jdavidguerrero/groovepush/hardware/boards/fab/pcb-a/pcb-a-bom.csv

Comment | Designator | Footprint | LCSC Part #
100nF | C1 | C_0603_1608Metric | C14663
10uF | C2 | C_0805_2012Metric | C15850
10nF | C10,C11,C12,C13,C14,C15,C16,C17,C18,C19,C20,C21,C22,C23,C24,C25 | C_0603_1608Metric | C57112
SM04B-SRSS-TB | J2 | JST_SH_SM04B-SRSS-TB_1x04-1MP_P1.00mm_Horizontal | C160404
SM06B-SRSS-TB | J3 | JST_SH_SM06B-SRSS-TB_1x06-1MP_P1.00mm_Horizontal | C160405
SM10B-SRSS-TB | J4 | JST_SH_SM10B-SRSS-TB_1x10-1MP_P1.00mm_Horizontal | C160409
4.7k | R1,R2 | R_0603_1608Metric | C23162
MCP23017T-E/SS | U1 | SSOP-28_5.3x10.2mm_P0.65mm | C558584
