jdavidguerrero/groovepush/hardware/boards/pcb-k2/pcb-k2.kicad_pcb

## KiCad design hardware/boards/pcb-k2/pcb-k2.kicad_pcb (2026-10-22)

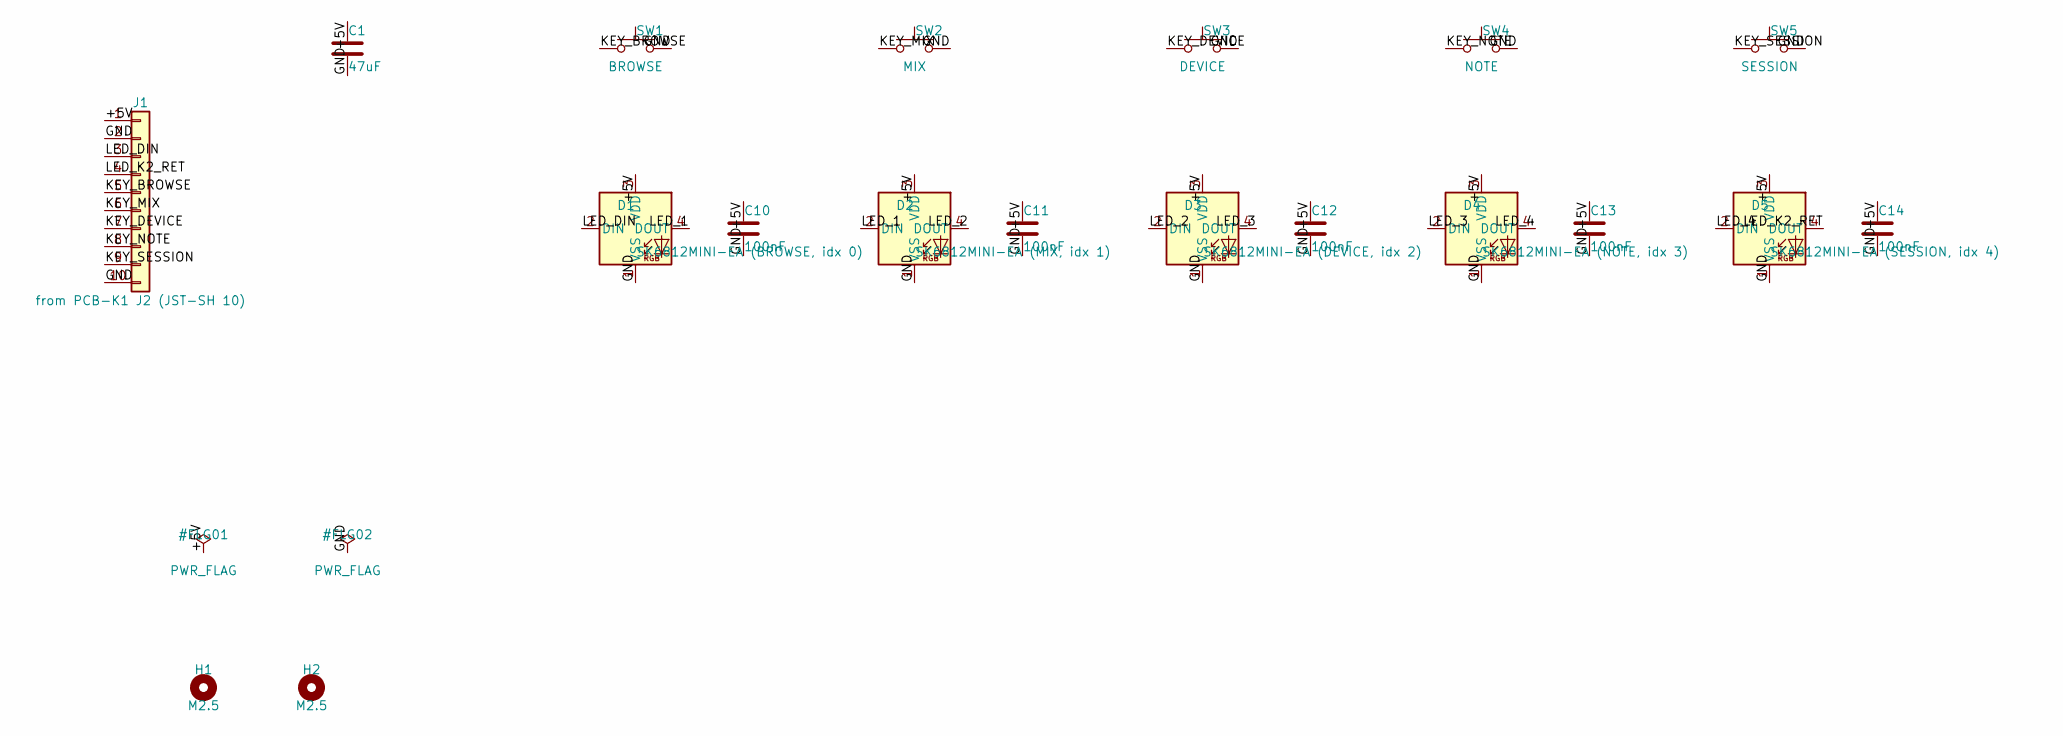
[picture p1: schematic pcb-k2.kicad_sch]

Parts:
C1: 47uF; C_1206_3216Metric
C10, C11, C12, C13, C14: 100nF; C_0603_1608Metric
D1: SK6812MINI-EA (BROWSE, idx 0); LED_SK6812MINI-E_3.2x2.8mm_P1.5mm_ReverseMount
D2: SK6812MINI-EA (MIX, idx 1); LED_SK6812MINI-E_3.2x2.8mm_P1.5mm_ReverseMount
D3: SK6812MINI-EA (DEVICE, idx 2); LED_SK6812MINI-E_3.2x2.8mm_P1.5mm_ReverseMount
D4: SK6812MINI-EA (NOTE, idx 3); LED_SK6812MINI-E_3.2x2.8mm_P1.5mm_ReverseMount
D5: SK6812MINI-EA (SESSION, idx 4); LED_SK6812MINI-E_3.2x2.8mm_P1.5mm_ReverseMount
H1, H2: M2.5; MountingHole_2.7mm_M2.5
J1: from PCB-K1 J2 (JST-SH 10); JST_SH_SM10B-SRSS-TB_1x10-1MP_P1.00mm_Horizontal
SW1: BROWSE; SW_Kailh_Choc_V2_1u
SW2: MIX; SW_Kailh_Choc_V2_1u
SW3: DEVICE; SW_Kailh_Choc_V2_1u
SW4: NOTE; SW_Kailh_Choc_V2_1u
SW5: SESSION; SW_Kailh_Choc_V2_1u

Connections:
/+5V: C1.1, C10.1, C11.1, C12.1, C13.1, C14.1, D1.3 (VDD), D2.3 (VDD), D3.3 (VDD), D4.3 (VDD), D5.3 (VDD), J1.1
/GND: C1.2, C10.2, C11.2, C12.2, C13.2, C14.2, D1.1 (VSS), D2.1 (VSS), D3.1 (VSS), D4.1 (VSS), D5.1 (VSS), J1.2, J1.10, SW1.2, SW2.2, SW3.2, SW4.2, SW5.2
/KEY_BROWSE: J1.5, SW1.1
/KEY_DEVICE: J1.7, SW3.1
/KEY_MIX: J1.6, SW2.1
/KEY_NOTE: J1.8, SW4.1
/KEY_SESSION: J1.9, SW5.1
/LED_1: D1.4 (DOUT), D2.2 (DIN)
/LED_2: D2.4 (DOUT), D3.2 (DIN)
/LED_3: D3.4 (DOUT), D4.2 (DIN)
/LED_4: D4.4 (DOUT), D5.2 (DIN)
/LED_DIN: D1.2 (DIN), J1.3
/LED_K2_RET: D5.4 (DOUT), J1.4

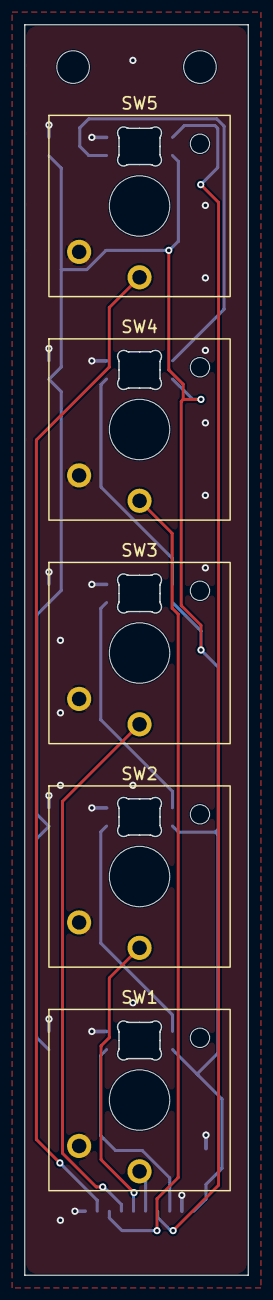
[picture p2: board pcb-k2.kicad_pcb from above]

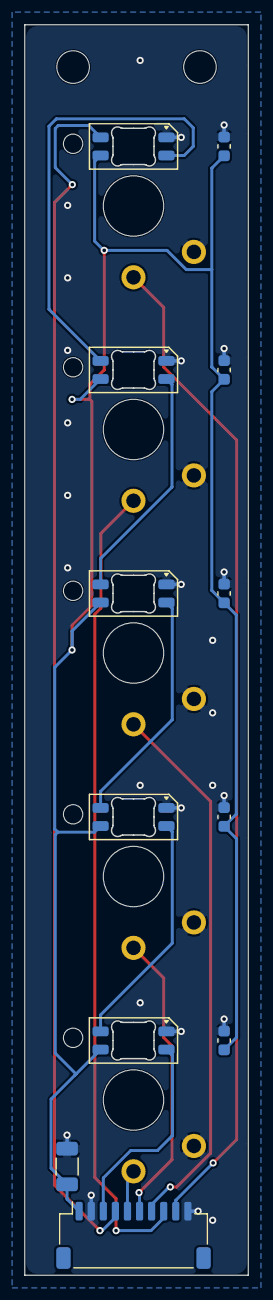
[picture p3: board pcb-k2.kicad_pcb from below]

Board: 2 copper layers, 18.5 x 103.5 mm, 19 parts (12 on the bottom side), 13 nets.
