jdavidguerrero/groovepush/hardware/boards/pcb-a/pcb-a.kicad_pcb

## KiCad design hardware/boards/pcb-a/pcb-a.kicad_pcb (2026-10-22)

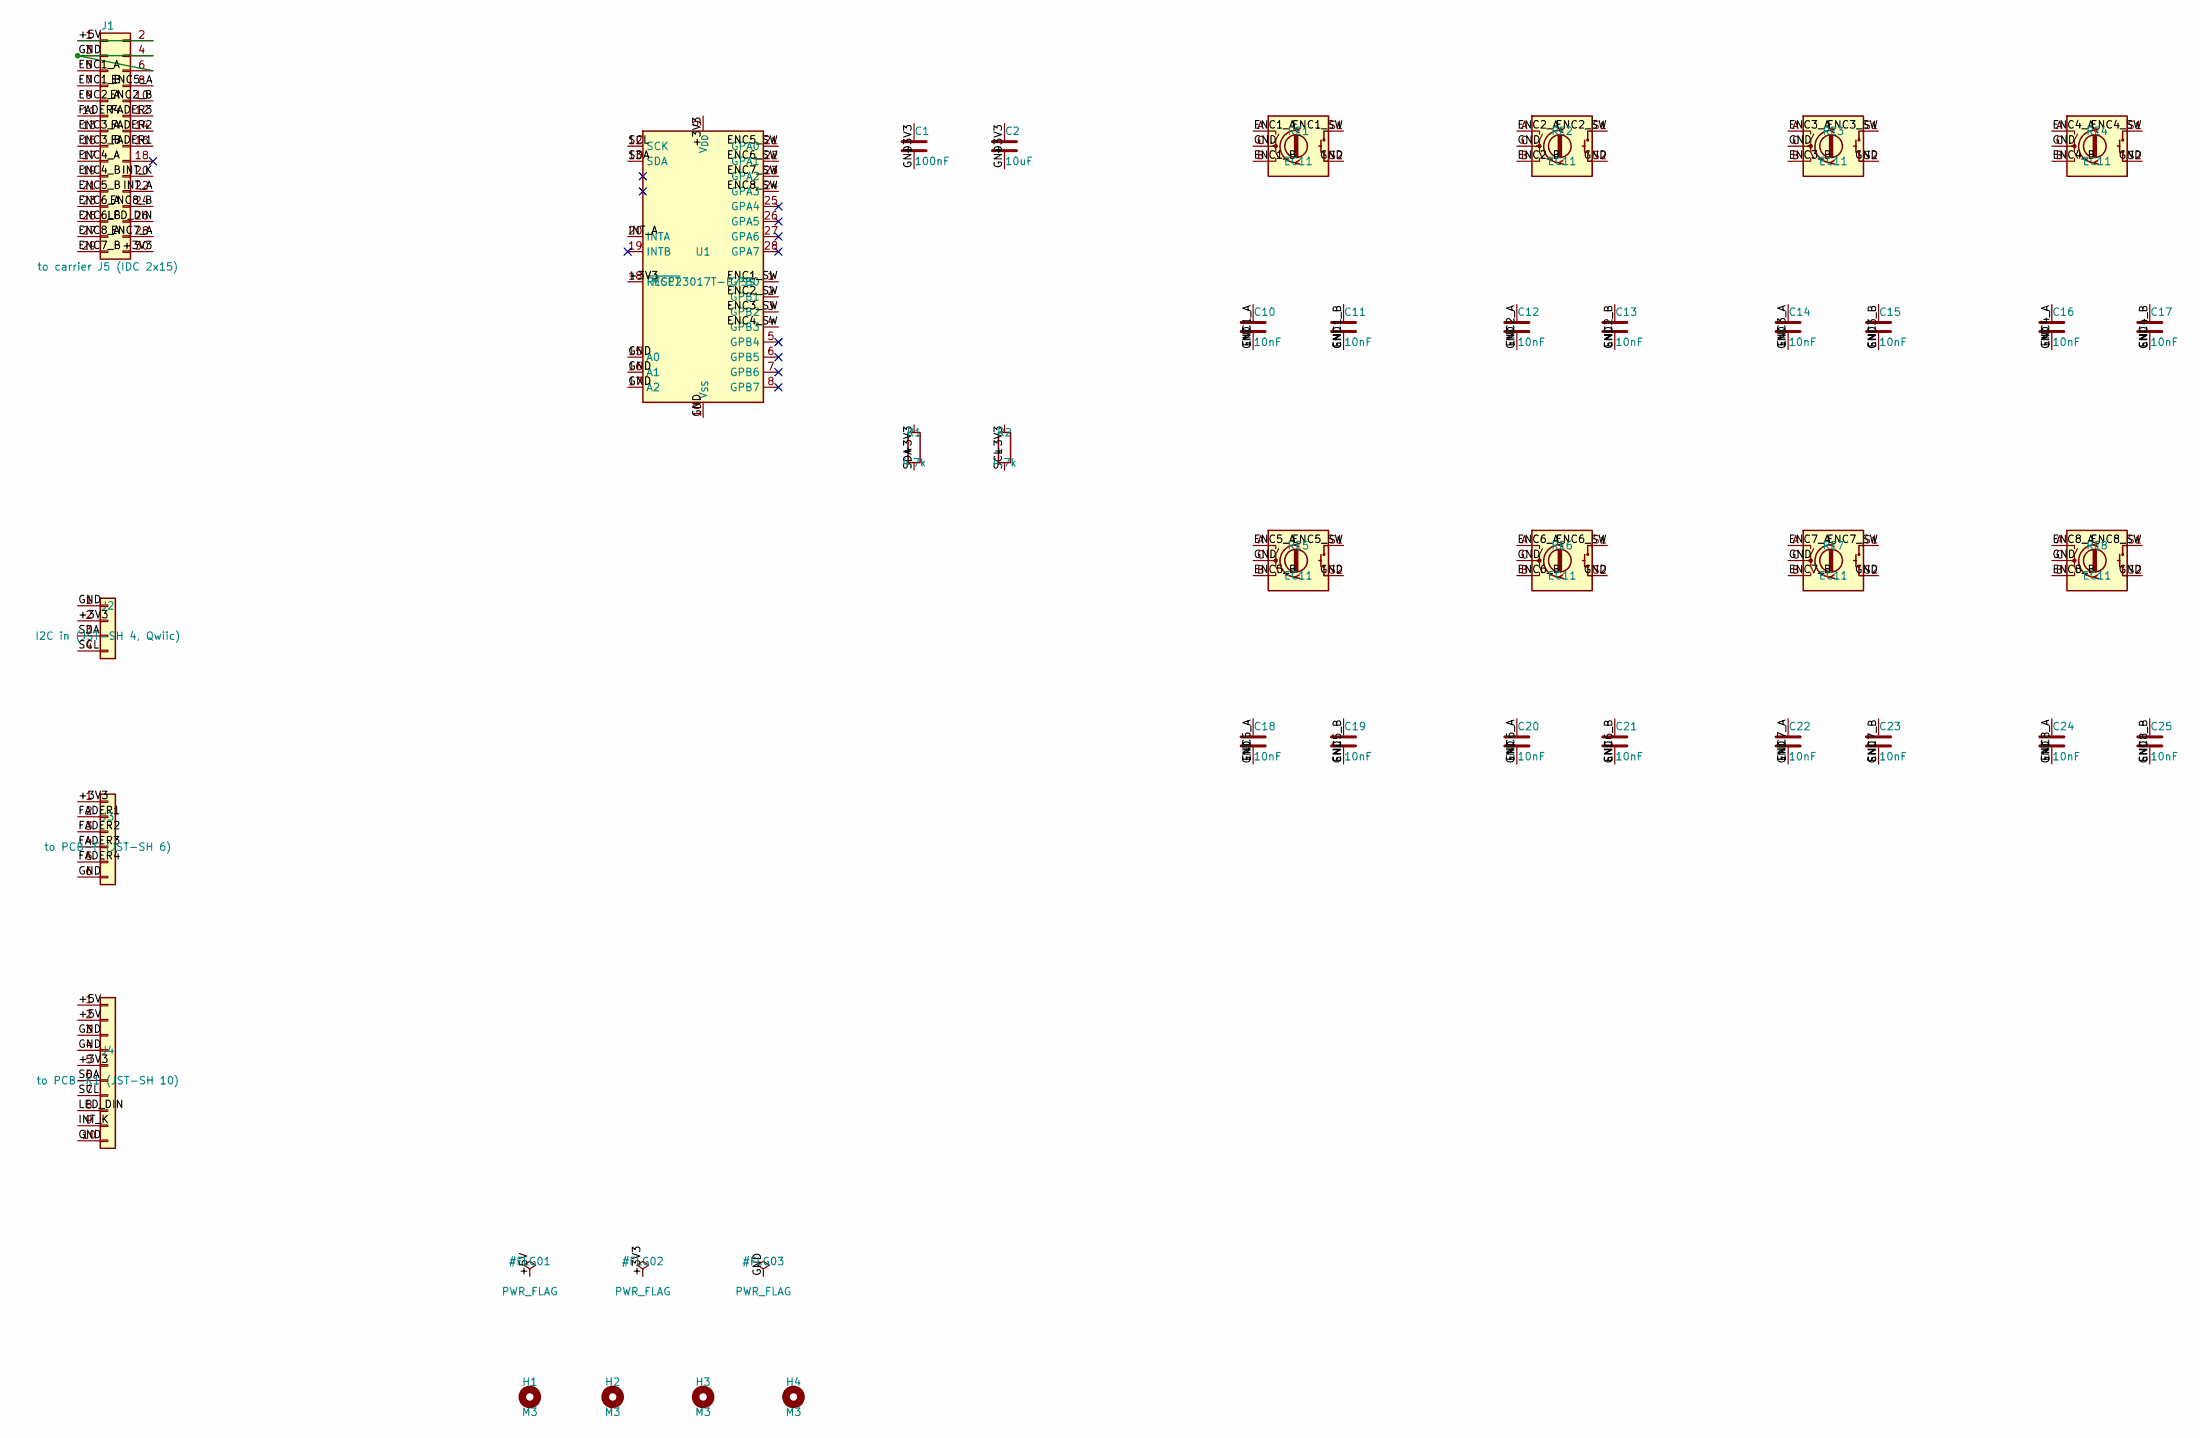
[picture p4: schematic pcb-a.kicad_sch]

Parts:
C1: 100nF; C_0603_1608Metric; LCSC C14663
C2: 10uF; C_0805_2012Metric; LCSC C15850
C10, C11, C12, C13, C14, C15, C16, C17, C18, C19, C20, C21, C22, C23, C24, C25: 10nF; C_0603_1608Metric; LCSC C57112
H1, H2, H3, H4: M3; MountingHole_3.2mm_M3
J1: to carrier J5 (IDC 2x15); IDC-Header_2x15_P2.54mm_Vertical
J2: I2C in (JST-SH 4, Qwiic); JST_SH_SM04B-SRSS-TB_1x04-1MP_P1.00mm_Horizontal; LCSC C160404
J3: to PCB-F (JST-SH 6); JST_SH_SM06B-SRSS-TB_1x06-1MP_P1.00mm_Horizontal; LCSC C160405
J4: to PCB-K1 (JST-SH 10); JST_SH_SM10B-SRSS-TB_1x10-1MP_P1.00mm_Horizontal; LCSC C160409
R1, R2: 4.7k; R_0603_1608Metric; LCSC C23162
RE1, RE2, RE3, RE4, RE5, RE6, RE7, RE8: EC11; RotaryEncoder_Alps_EC11E-Switch_Vertical_H20mm
U1: MCP23017T-E/SS; SSOP-28_5.3x10.2mm_P0.65mm; LCSC C558584

Connections:
/+3V3: C1.1, C2.1, J1.30, J2.2, J3.1, J4.5, R1.1, R2.1, U1.9 (V_{DD}), U1.18 (~RESET)
/+5V: J1.1, J1.2, J4.1, J4.2
/ENC1_A: C10.1, J1.5, RE1.A
/ENC1_B: C11.1, J1.7, RE1.B
/ENC1_SW: RE1.S1, U1.1 (GPB0)
/ENC2_A: C12.1, J1.9, RE2.A
/ENC2_B: C13.1, J1.10, RE2.B
/ENC2_SW: RE2.S1, U1.2 (GPB1)
/ENC3_A: C14.1, J1.13, RE3.A
/ENC3_B: C15.1, J1.15, RE3.B
/ENC3_SW: RE3.S1, U1.3 (GPB2)
/ENC4_A: C16.1, J1.17, RE4.A
/ENC4_B: C17.1, J1.19, RE4.B
/ENC4_SW: RE4.S1, U1.4 (GPB3)
/ENC5_A: C18.1, J1.8, RE5.A
/ENC5_B: C19.1, J1.21, RE5.B
/ENC5_SW: RE5.S1, U1.21 (GPA0)
/ENC6_A: C20.1, J1.23, RE6.A
/ENC6_B: C21.1, J1.25, RE6.B
/ENC6_SW: RE6.S1, U1.22 (GPA1)
/ENC7_A: C22.1, J1.28, RE7.A
/ENC7_B: C23.1, J1.29, RE7.B
/ENC7_SW: RE7.S1, U1.23 (GPA2)
/ENC8_A: C24.1, J1.27, RE8.A
/ENC8_B: C25.1, J1.24, RE8.B
/ENC8_SW: RE8.S1, U1.24 (GPA3)
/FADER1: J1.16, J3.2
/FADER2: J1.14, J3.3
/FADER3: J1.12, J3.4
/FADER4: J1.11, J3.5
/GND: C1.2, C2.2, C10.2, C11.2, C12.2, C13.2, C14.2, C15.2, C16.2, C17.2, C18.2, C19.2, C20.2, C21.2, C22.2, C23.2, C24.2, C25.2, J1.3, J1.4, J1.6, J2.1, J3.6, J4.3, J4.4, J4.10, RE1.C, RE1.S2, RE2.C, RE2.S2, RE3.C, RE3.S2, RE4.C, RE4.S2, RE5.C, RE5.S2, RE6.C, RE6.S2, RE7.C, RE7.S2, RE8.C, RE8.S2, U1.10 (V_{SS}), U1.15 (A0), U1.16 (A1), U1.17 (A2)
/INT_A: J1.22, U1.20 (INTA)
/INT_K: J1.20, J4.9
/LED_DIN: J1.26, J4.8
/SCL: J2.4, J4.7, R2.2, U1.12 (SCK)
/SDA: J2.3, J4.6, R1.2, U1.13 (SDA)

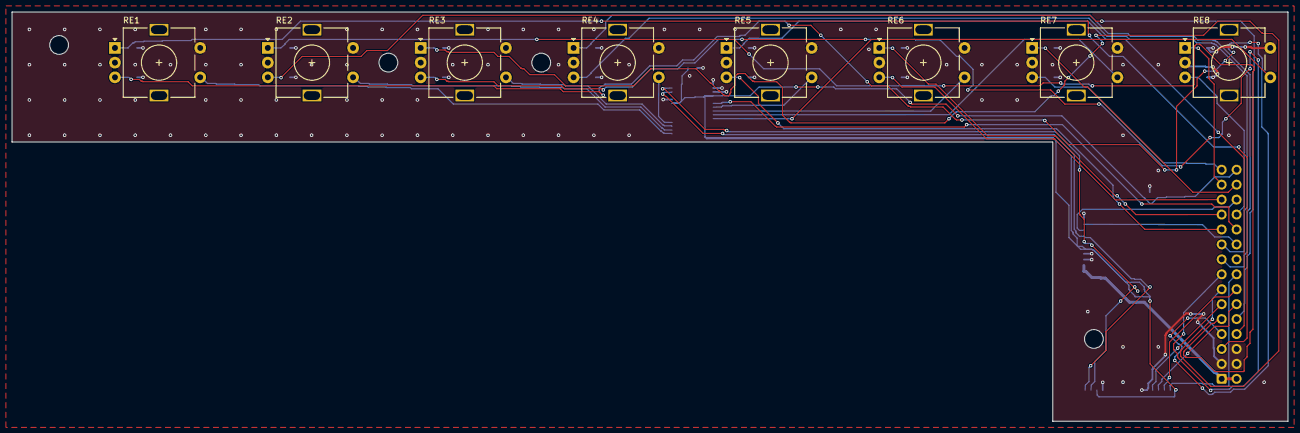
[picture p5: board pcb-a.kicad_pcb from above]

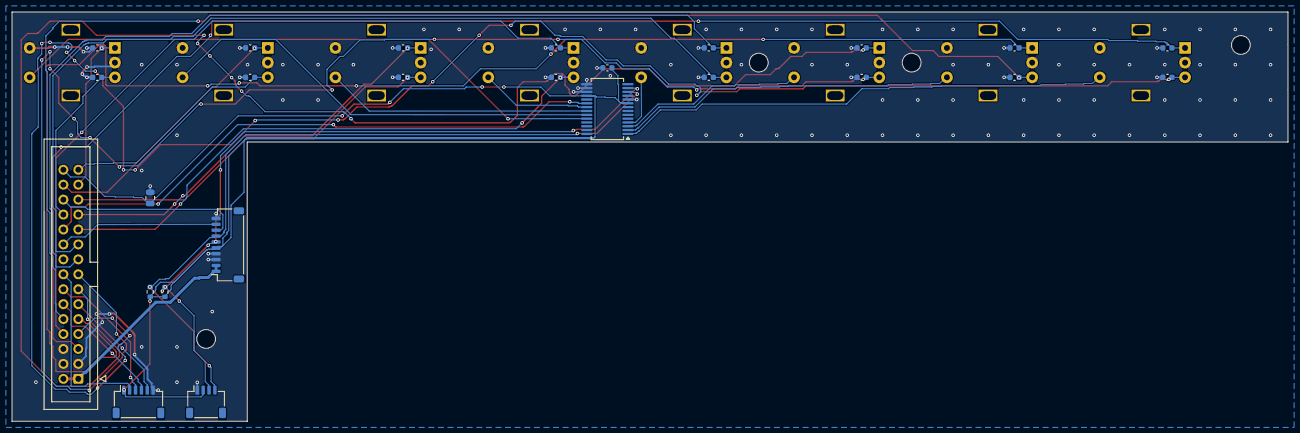
[picture p6: board pcb-a.kicad_pcb from below]

Board: 2 copper layers, 217.0 x 69.6 mm, 37 parts (25 on the bottom side), 36 nets.
