jdavidguerrero/groovepush/hardware/boards/pcb-k1/pcb-k1.kicad_pcb

## KiCad design hardware/boards/pcb-k1/pcb-k1.kicad_pcb (2026-10-22)

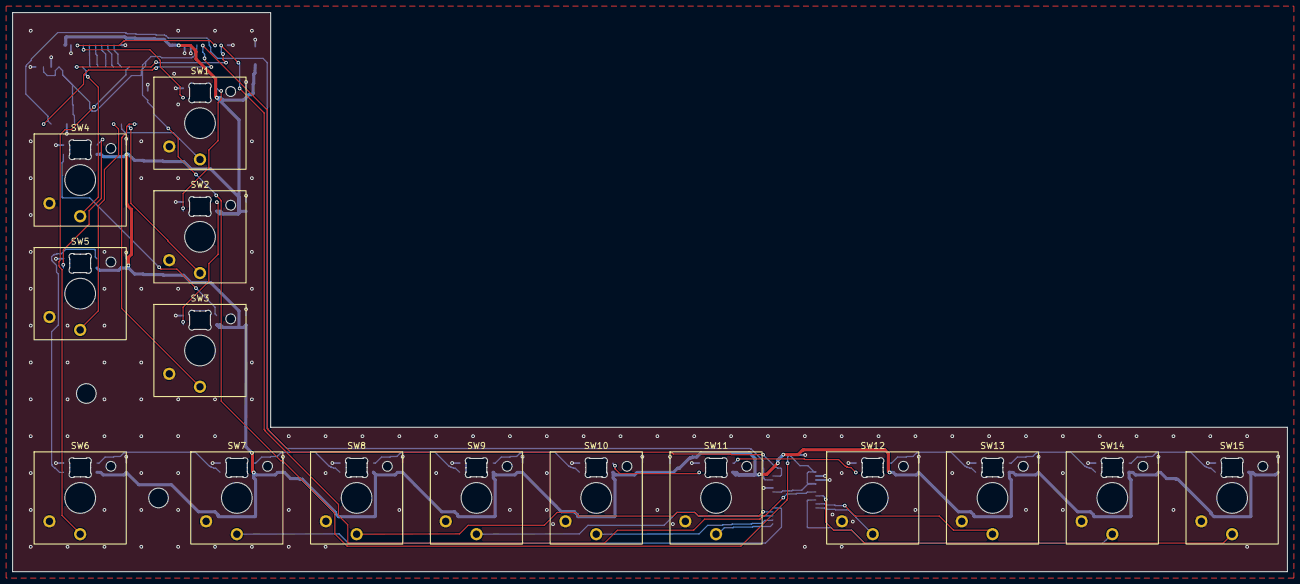
[picture p7: board pcb-k1.kicad_pcb from above]

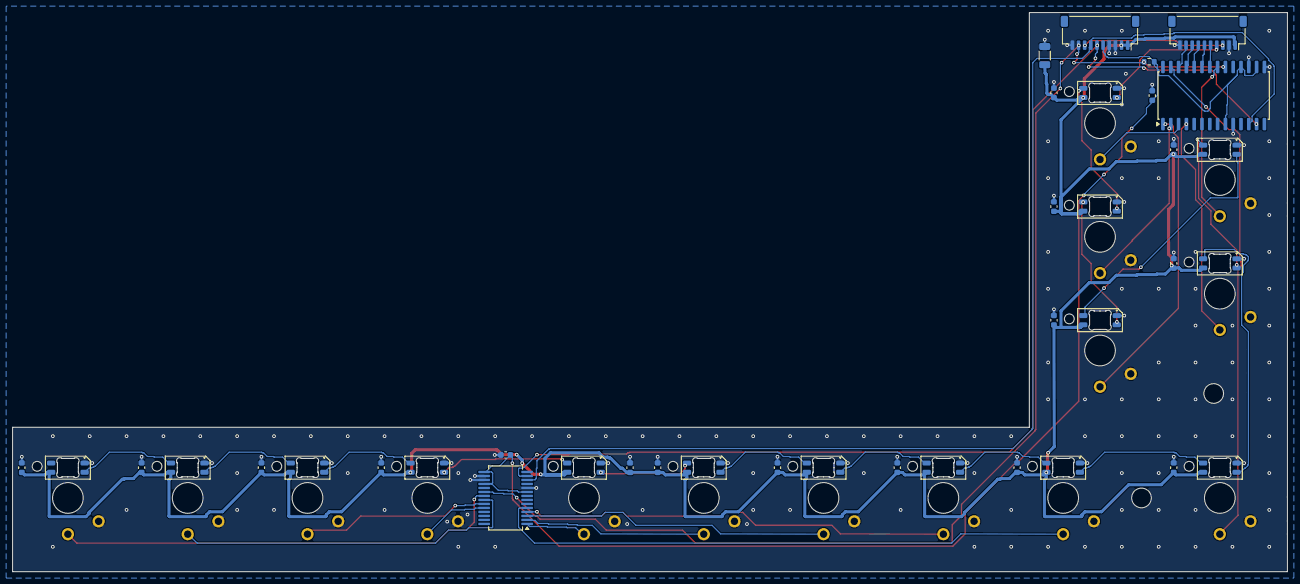
[picture p8: board pcb-k1.kicad_pcb from below]

Board: 2 copper layers, 207.5 x 91.0 mm, 55 parts (38 on the bottom side), 42 nets.

Parts:
C1, C2, C10, C11, C12, C13, C14, C15, C16, C17, C18, C19, C20, C21, C22, C23, C24: 100nF; C_0603_1608Metric
C3: 47uF; C_1206_3216Metric
D1: SK6812MINI-EA (QUANTIZE, idx 5); LED_SK6812MINI-E_3.2x2.8mm_P1.5mm_ReverseMount
D2: SK6812MINI-EA (DUPLICATE, idx 6); LED_SK6812MINI-E_3.2x2.8mm_P1.5mm_ReverseMount
D3: SK6812MINI-EA (DELETE, idx 7); LED_SK6812MINI-E_3.2x2.8mm_P1.5mm_ReverseMount
D4: SK6812MINI-EA (UNDO, idx 8); LED_SK6812MINI-E_3.2x2.8mm_P1.5mm_ReverseMount
D5: SK6812MINI-EA (NEW, idx 9); LED_SK6812MINI-E_3.2x2.8mm_P1.5mm_ReverseMount
D6: SK6812MINI-EA (SHIFT, idx 10); LED_SK6812MINI-E_3.2x2.8mm_P1.5mm_ReverseMount
D7: SK6812MINI-EA (PLAY, idx 11); LED_SK6812MINI-E_3.2x2.8mm_P1.5mm_ReverseMount
D8: SK6812MINI-EA (STOP, idx 12); LED_SK6812MINI-E_3.2x2.8mm_P1.5mm_ReverseMount
D9: SK6812MINI-EA (RECORD, idx 13); LED_SK6812MINI-E_3.2x2.8mm_P1.5mm_ReverseMount
D10: SK6812MINI-EA (LOOP, idx 14); LED_SK6812MINI-E_3.2x2.8mm_P1.5mm_ReverseMount
D11: SK6812MINI-EA (METRO, idx 15); LED_SK6812MINI-E_3.2x2.8mm_P1.5mm_ReverseMount
D12: SK6812MINI-EA (BANK_L, idx 16); LED_SK6812MINI-E_3.2x2.8mm_P1.5mm_ReverseMount
D13: SK6812MINI-EA (BANK_R, idx 17); LED_SK6812MINI-E_3.2x2.8mm_P1.5mm_ReverseMount
D14: SK6812MINI-EA (OCT_DN, idx 18); LED_SK6812MINI-E_3.2x2.8mm_P1.5mm_ReverseMount
D15: SK6812MINI-EA (OCT_UP, idx 19); LED_SK6812MINI-E_3.2x2.8mm_P1.5mm_ReverseMount
H1, H2: M3; MountingHole_3.2mm_M3
J1: from PCB-A J4 (JST-SH 10); JST_SH_SM10B-SRSS-TB_1x10-1MP_P1.00mm_Horizontal
J2: to PCB-K2 J1 (JST-SH 10); JST_SH_SM10B-SRSS-TB_1x10-1MP_P1.00mm_Horizontal
R1: 10k; R_0603_1608Metric
SW1: QUANTIZE; SW_Kailh_Choc_V2_1u
SW2: DUPLICATE; SW_Kailh_Choc_V2_1u
SW3: DELETE; SW_Kailh_Choc_V2_1u
SW4: UNDO; SW_Kailh_Choc_V2_1u
SW5: NEW; SW_Kailh_Choc_V2_1u
SW6: SHIFT; SW_Kailh_Choc_V2_1u
SW7: PLAY; SW_Kailh_Choc_V2_1u
SW8: STOP; SW_Kailh_Choc_V2_1u
SW9: RECORD; SW_Kailh_Choc_V2_1u
SW10: LOOP; SW_Kailh_Choc_V2_1u
SW11: METRO; SW_Kailh_Choc_V2_1u
SW12: BANK_L; SW_Kailh_Choc_V2_1u
SW13: BANK_R; SW_Kailh_Choc_V2_1u
SW14: OCT_DN; SW_Kailh_Choc_V2_1u
SW15: OCT_UP; SW_Kailh_Choc_V2_1u
U1: MCP23017T-E/SS @0x21; SSOP-28_5.3x10.2mm_P0.65mm
U2: MCP23017-E/SO @0x22; SOIC-28W_7.5x17.9mm_P1.27mm

Connections:
/+3V3: C1.1, C2.1, J1.5, R1.1, U1.9, U1.15, U1.18, U2.9, U2.16, U2.18
/+5V: C3.1, C10.1, C11.1, C12.1, C13.1, C14.1, C15.1, C16.1, C17.1, C18.1, C19.1, C20.1, C21.1, C22.1, C23.1, C24.1, D1.3, D2.3, D3.3, D4.3, D5.3, D6.3, D7.3, D8.3, D9.3, D10.3, D11.3, D12.3, D13.3, D14.3, D15.3, J1.1, J1.2, J2.1
/GND: C1.2, C2.2, C3.2, C10.2, C11.2, C12.2, C13.2, C14.2, C15.2, C16.2, C17.2, C18.2, C19.2, C20.2, C21.2, C22.2, C23.2, C24.2, D1.1, D2.1, D3.1, D4.1, D5.1, D6.1, D7.1, D8.1, D9.1, D10.1, D11.1, D12.1, D13.1, D14.1, D15.1, J1.3, J1.4, J1.10, J2.2, J2.10, SW1.2, SW2.2, SW3.2, SW4.2, SW5.2, SW6.2, SW7.2, SW8.2, SW9.2, SW10.2, SW11.2, SW12.2, SW13.2, SW14.2, SW15.2, U1.10, U1.16, U1.17, U2.10, U2.15, U2.17
/INT_K: J1.9, R1.2, U1.20, U2.20
/KEY_BANK_L: SW12.1, U1.24
/KEY_BANK_R: SW13.1, U1.23
/KEY_BROWSE: J2.5, U2.22
/KEY_DELETE: SW3.1, U2.1
/KEY_DEVICE: J2.7, U2.24
/KEY_DUPLICATE: SW2.1, U2.2
/KEY_LOOP: SW10.1, U1.2
/KEY_METRO: SW11.1, U1.1
/KEY_MIX: J2.6, U2.23
/KEY_NEW: SW5.1, U2.4
/KEY_NOTE: J2.8, U2.25
/KEY_OCT_DN: SW14.1, U1.22
/KEY_OCT_UP: SW15.1, U1.21
/KEY_PLAY: SW7.1, U1.5
/KEY_QUANTIZE: SW1.1, U2.3
/KEY_RECORD: SW9.1, U1.3
/KEY_SESSION: J2.9, U2.26
/KEY_SHIFT: SW6.1, U2.27
/KEY_STOP: SW8.1, U1.4
/KEY_UNDO: SW4.1, U2.21
/LED_1: D1.4, D2.2
/LED_2: D2.4, D3.2
/LED_3: D3.4, D4.2
/LED_4: D4.4, D5.2
/LED_5: D5.4, D6.2
/LED_6: D6.4, D7.2
/LED_7: D7.4, D8.2
/LED_8: D8.4, D9.2
/LED_9: D9.4, D10.2
/LED_10: D10.4, D11.2
/LED_11: D11.4, D12.2
/LED_12: D12.4, D13.2
/LED_13: D13.4, D14.2
/LED_14: D14.4, D15.2
/LED_DIN: J1.8, J2.3
/LED_K2_RET: D1.2, J2.4
/SCL: J1.7, U1.12, U2.12
/SDA: J1.6, U1.13, U2.13
