jdavidguerrero/groovepush/hardware/boards/pcb-f/pcb-f.kicad_pcb

## KiCad design hardware/boards/pcb-f/pcb-f.kicad_pcb (2026-10-22)

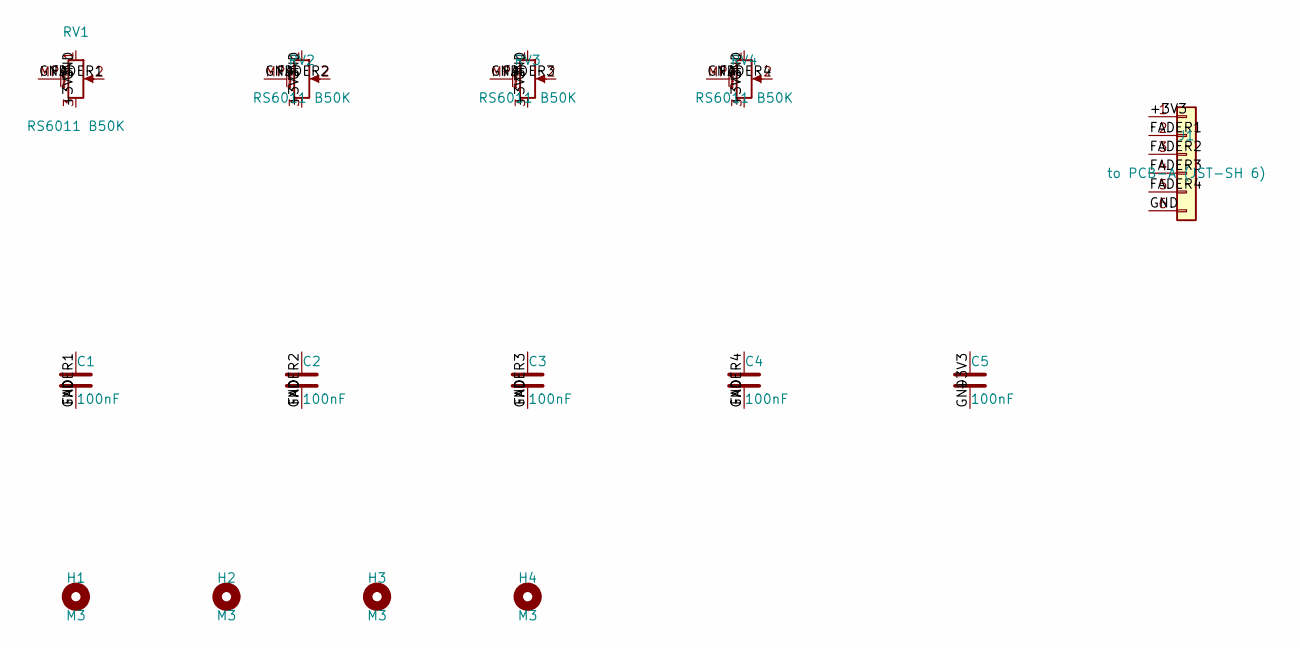
[picture p9: schematic pcb-f.kicad_sch]

Parts:
C1, C2, C3, C4, C5: 100nF; C_0603_1608Metric
H1, H2, H3, H4: M3; MountingHole_3.2mm_M3
J1: to PCB-A (JST-SH 6); JST_SH_SM06B-SRSS-TB_1x06-1MP_P1.00mm_Horizontal
RV1, RV2, RV3, RV4: RS6011 B50K; ALPS_RS6011P_60mm

Connections:
/+3V3: C5.1, J1.1, RV1.3, RV2.3, RV3.3, RV4.3
/FADER1: C1.1, J1.2, RV1.2
/FADER2: C2.1, J1.3, RV2.2
/FADER3: C3.1, J1.4, RV3.2
/FADER4: C4.1, J1.5, RV4.2
/GND: C1.2, C2.2, C3.2, C4.2, C5.2, J1.6, RV1.1, RV1.MP (MountPin), RV2.1, RV2.MP (MountPin), RV3.1, RV3.MP (MountPin), RV4.1, RV4.MP (MountPin)

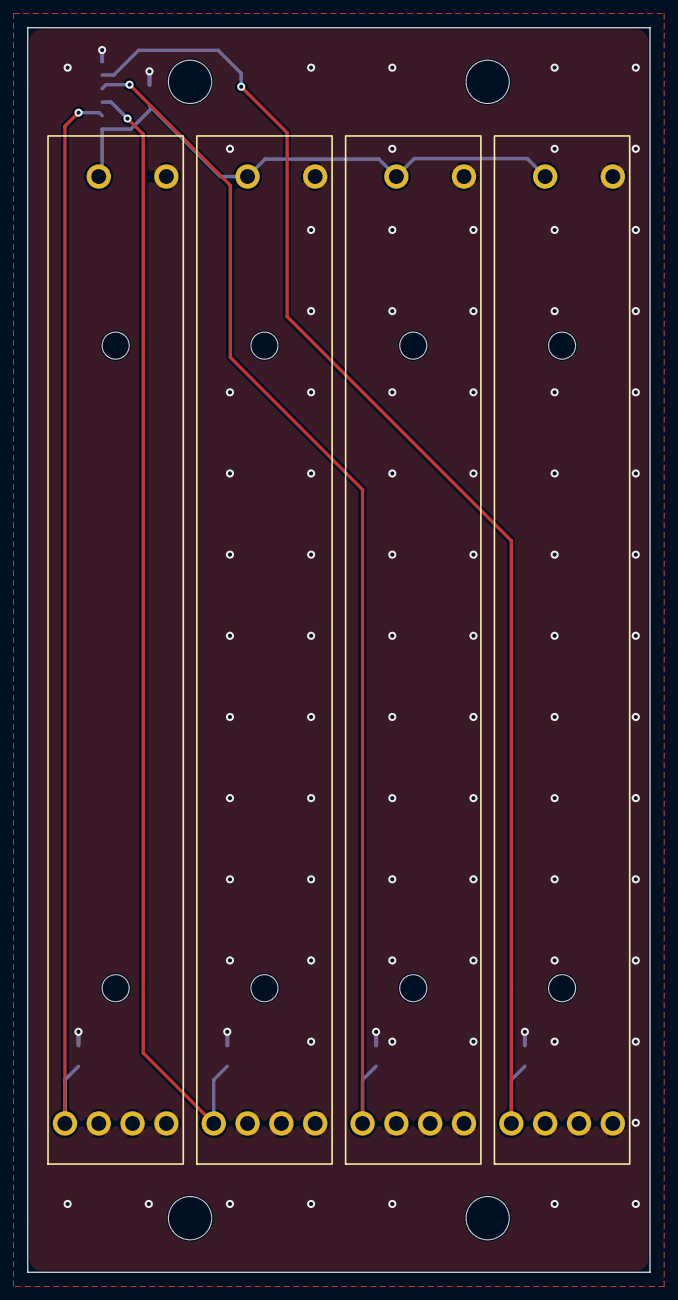
[picture p10: board pcb-f.kicad_pcb from above]

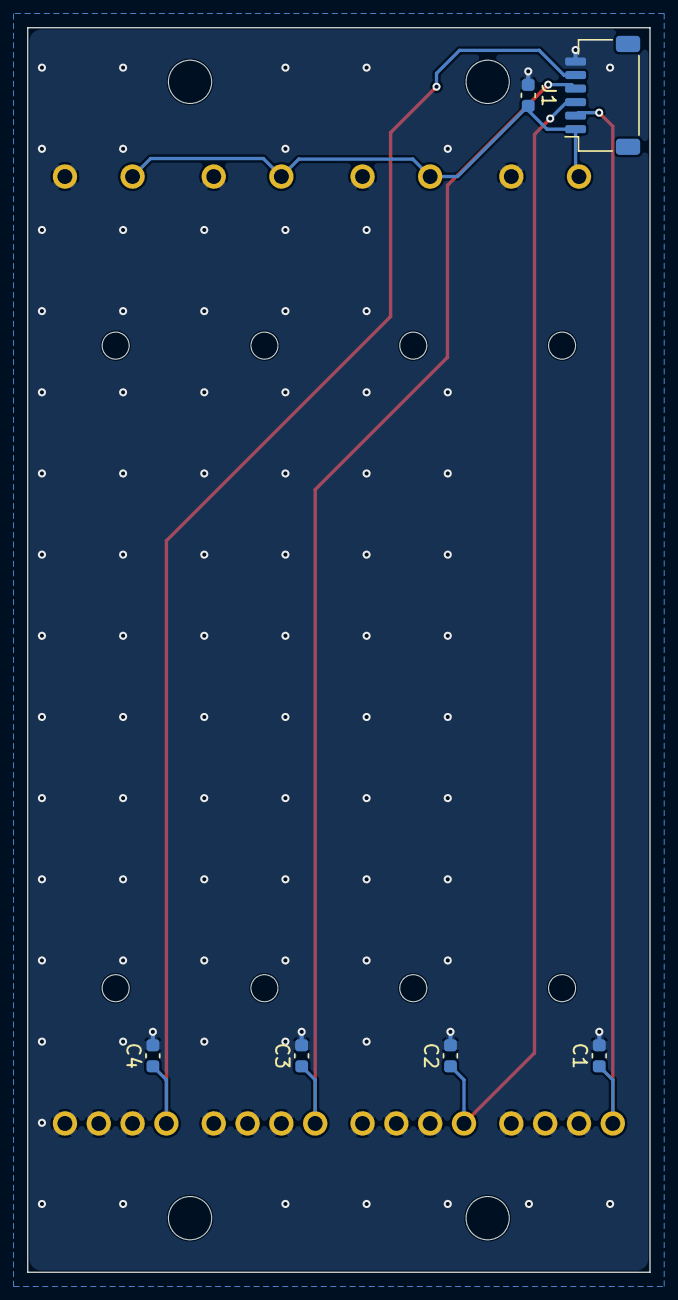
[picture p11: board pcb-f.kicad_pcb from below]

Board: 2 copper layers, 46.0 x 92.0 mm, 14 parts (6 on the bottom side), 6 nets.
