jdavidguerrero/groovepush/(commit log)

2026-07-16 chore: finalize monorepo layout (docs, specs, per-app packages)
    - Move planning docs to specs/ (push-controller-groovepilot.md, push-controller-gui-design.md)
    - Add per-app package.json wrappers for pnpm workspace orchestration
    - Add docs/MONOREPO_MIGRATION.md
    - Placeholder for hardware/ (KiCad, Phase 3)
2026-07-16 chore(remote-script): sync live working-tree state from Ableton folder
    Bring apps/remote-script up to the current state of the live deploy folder
    (~/Music/Ableton/.../Remote Scripts/PushClone): uncommitted edits to 15 tracked
    files plus untracked sources/docs (SessionOverview.py, api-contract-definition.md,
    CHANGELOG.md, MIDI_PROTOCOL_REFERENCE.md, dev scripts, lom_full.txt).
    Excluded: __pycache__, .DS_Store, and the 1.1MB LOM PDF.
2026-07-16 feat: Phase 3 — modular hierarchical KiCad schematic (hardware/)
    - KiCad v10 project with root + 4 module sub-sheets (processor, encoders, analog, leds).
    - Processor: Teensy 4.1 socket, 2x MCP23017 (0x20/0x21), I2C pull-ups, decoupling,
    and inter-board connectors (NeoTrellis I2C, RPi UART, power, encoder/analog/LED, buttons).
    - Encoders: 8x EC11 (A/B + switch) with ribbon interface.
    - Analog: 4x ALPS B50K faders, 4x piezo (1M bleed), 2x Sharp IR.
    - LEDs: SN74LVC245 level shifter, 330R series, WS2812B chain, 1000uF bulk.
    - Connectivity validated via MCP net lister; PWR_FLAGs + no-connects placed.
    - hardware/README.md: BOM per module + inter-board connector contract + power budget.
    - ADR-0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
    [GroovePush.kicad_pcb, GroovePush.kicad_sch, analog.kicad_sch, encoders.kicad_sch, leds.kicad_sch, processor.kicad_sch]
2026-07-16 docs: Phase 4 — OpenSpecs + gap analysis (GAPS_AND_IMPROVEMENTS.md)
    - specs/openspec/push-controller.md: integration umbrella (adopts groovepilot doc as
    normative, assigns R-PUSHCTRL-* ids).
    - specs/openspec/processor.md (SPEC-PROC), gui.md (SPEC-GUI): OpenSpecs for both parts,
    grounded in current code, mapped to target requirements + acceptance criteria.
    - GAPS_AND_IMPROVEMENTS.md: current-vs-target maturity, per-component gaps (G-P*, G-G*,
    G-RS*, G-I*, G-H*), urgent refactorings, and a P0–P3 priority matrix.
    - Code survey confirms the AI/intelligence layer is unstarted; existing controller is the
    foundation to extend.
2026-07-16 docs: Phase 5 — progressive rebuild roadmap with content blocks
    12 sequential blocks (0-12) from protoboard bring-up to AI copilot features. Each block
    is a technical milestone + a content episode (topic + video type), traceable to gaps and
    OpenSpecs. Reuses existing test_* bring-up envs as content moments. Structured for Notion.
2026-07-16 feat(processor): Block 0 — reconcile pin map source of truth (G-P1/G-P2/G-P3)
    - Add apps/processor/PIN_MAP.md: single authoritative, conflict-free Teensy 4.1 map
    (encoders avoid Serial1 0/1, I2C Wire 18/19, faders 14-17, piezo/IR 20-25, NeoPixel 33).
    - Config.h: coherent encoder pins, I2C bus note, NEOPIXEL_PIN, UART-M4 marked deprecated.
    - Remove orphan include/Config.h (dead, contradictory values).
    - PIN_DISTRIBUTION.md: banner pointing to PIN_MAP.md as source of truth.
    - Verified: pio run -e teensy41 SUCCESS (24s).
    - SDD: specs/openspec/processor.tasks.md (Block 0 done, Block 1 next).
    - Content (Notion-ready): docs/content/ calendar CSV + Block 0 script.
    - GAPS: mark G-P1/G-P2/G-P3 re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
    [content-calendar.csv]
2026-07-16 docs(content): link the live Notion content calendar
    Notion connector authorized; created 'GroovePush Content Calendar' database (13 pages,
    Block 0-12) under a 'GroovePush - Build & Content Hub' page, each with its full script.
    Block 0 marked Done. Update docs/content/README.md with the real links.
2026-07-17 docs: ADR-0002 — dual-mode direction (Push Controller vs Standalone)
    Record the future direction: a Standalone mode where the RPi5 hosts the local
    sequencer/pattern engine (not the Teensy) and gains audio I/O via RaspiAudio HATs.
    Verified Audio+V2 specs against the manufacturer (112dB, 32-bit/384kHz, I2S, RPi5-
    compatible, output-only DAC — no mic input) before adding it to the hardware BOM.
    Mic+ (audio input) tracked as a planned future BOM addition.
    Explicitly marks what's NOT decided yet: mode-switch mechanism, standalone engine
    ownership, standalone UI reuse, and how local RPi5 audio capture interacts with
    principle C-4 (audio never leaves the machine). All current specs still descr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
2026-07-17 feat(processor): Phase 1 scope narrowing + MCP23017 button erratum fix
    Scope reduction (user decision, Block 0 continuation):
    - Remove piezo/IR/theremin from GroovePush entirely (future standalone e-drum module).
    - Remove capacitive touch buttons, replaced by MCP23017 pushbuttons.
    - Defer WS2812B LED strip to PCB phase (SMD parts on hand, not protoboard-friendly).
    - Confirmed BOM: 0 extra buttons for encoders (EC11 integrated switch), 4 pushbuttons
    for transport (Play/Stop/Record/Loop) on MCP 0x21, 4 more wired-and-free for later.
    Bug fix (found while verifying against hardware/processor.kicad_sch):
    - ButtonManager.cpp mapped METRONOME and the disabled ENC_8 to MCP library pin 7
    (GPA7)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
    [Config.h]
2026-07-17 feat(processor,remote-script): wire physical UNDO button end-to-end
    MCP #2's unused BANK_LEFT slot is now UNDO. CMD_UNDO (0x4D) existed as a constant
    on both ends but had no handler anywhere -- added TransportManager.trigger_undo()
    (Song.undo()) and routed it from handle_transport_command. One MCP #2 slot (lib
    pin 5) stays unassigned by user choice; METRONOME still triggers a mixer-mode
    toggle instead of a literal click, pending confirmation (see GAPS G-P13).
    Verified: pio run -e teensy41 SUCCESS, same FLASH/RAM footprint.
2026-07-20 hw(analog): mark piezo/IR components DNP (removed from scope)
    J12-J15 (Piezo1-4 connectors), R3-R6 (1M bleed resistors), J16/J17 (IR1/IR2
    Sharp connectors) set to Do Not Populate -- piezo/IR/theremin are out of
    GroovePush's scope (future e-drum module, gap G-P11). Symbols and wiring
    kept intact rather than deleted, matching the firmware-side pattern
    (Piezo.cpp/Theremin.cpp stay in the tree, just disabled).
    Faders (RV1-4) and the shared J11 interconnect are untouched -- still
    active Phase 1 hardware.
    Done via direct dnp field edits since the KiCad MCP server was
    disconnected (no ERC available to validate a structural deletion); this
    is the lower-risk, reversible option. Re-run ERC once MCP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
2026-10-19 spec: 7" multitouch GUI, Brain identity, standalone with Brain, +12 buttons
    Review of 2026-10-19 against GrooveForge Brain:
    - ADR-0003: GUI stays Qt 6 / QML on the Pi 5, native 1280x720 for the
    Waveshare 7" 10-point multitouch panel; palette and typography unified
    with the Brain (studio-head theme.h, IBM Plex Mono). Open question:
    purple means AI here but FX chrome in the Brain.
    - ADR-0002 Rev. 1: standalone keeps Pi 5 + Audio+ V2; when a Brain is
    connected, sound can be handed off to it over its USB-A MIDI host.
    The Brain's host port is receive-only today (gap G-X1).
    - ADR-0004: +12 function buttons on GPB1-GPB6 of both MCP23017s (28
    inputs, chips full); Kailh Choc V2 + SK6812-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
2026-10-19 docs(design): Claude Design enclosure prompt; evaluate reusing the Brain carrier
    - docs/design/claude-design-prompt-enclosure.md: same structure as the
    Brain Studio enclosure prompt (family identity, aluminium + PETG),
    with the GroovePush parts: Waveshare 7" 1280x720, 8 EC11, 2x NeoTrellis,
    4 faders, 20 Choc V2 keys by group, Pi 5 + Audio+ V2, the Brain carrier
    (97 x 100 mm). Known conflict to solve: 8 encoders under 19.4 mm
    soft-key cells.
    - GAPS G-H10: reusing the Brain carrier is viable (23 GPIO on J5, UART on
    J6, power already protected); I2C has to come from the empty Audio
    Shield socket J15, encoder pins move, Pi 5 needs its own supply.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
2026-10-19 docs: the pad grid is a NeoTrellis M4 over UART, not I2C Seesaw boards
    The user's grid is one Adafruit NeoTrellis M4 (product 3938, 120 x 62 x
    8.3 mm). The July Block 0 call (G-P2: "I2C 0x2E/0x2F authoritative, M4
    UART deprecated") was wrong; the firmware already talks to the M4 on
    Serial1 @ 1 Mbps and to the Pi on Serial2 (7/8).
    - Reverse G-P2; correct PIN_MAP (Serial1 = M4, Serial2 = Pi, no Seesaw
    addresses), CLAUDE.md, the ADR-0001 note, SPEC-PROC and the enclosure
    prompt.
    - Record G-P14: the Block 0 encoder map puts Enc3/Enc4 on pins 7 and 8,
    which are Serial2 (the GUI link). The original map avoided them. Fix
    goes with the carrier decision (G-H10).
    - Note that the M4's elastome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
2026-10-19 feat(processor): re-map pins to the GrooveForge Brain carrier, fix encoder/UART clash
    GroovePush uses the Brain's portadora unmodified (G-H10). Every Teensy pin
    now follows that board's connectors:
    - GUI (Pi 5) on Serial1 via J6; NeoTrellis M4 on Serial5 (TX5 20, RX5 21)
    via the empty Audio Shield socket J15; ports set once in Config.h
    (TEENSY_GUI_SERIAL / TEENSY_M4_SERIAL) instead of hard-coded Serial1/2.
    - Encoders on J5: {2,3, 4,5, 9,10, 11,12, 22,24, 26,30, 31,32, 34,35};
    faders stay on 14-17; LED data on 28 (carrier buffer -> J5.26);
    optional MCP INT lines on 40/41.
    - Fixes G-P14: the Block 0 map put Enc3/Enc4 on pins 7/8, the GUI's
    Serial2.
    - PIN_MAP.md gains the carrier con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
2026-10-19 docs(design): enclosure v1 from Claude Design, real part data, v2 iteration prompt
    - Save the Claude Design v1 output (docs/design/claude-design-2026-10-19-v1).
    - Base prompt now carries real data: Waveshare 7" module 189.32 x 120.24
    (active 155 x 88, centred), ~50 mm Pi 5 + cooler + HAT stack, ALPS RS6011
    faders (60 mm travel, 75 x 9 x 7 body), NeoTrellis M4 holes and connector
    edge (micro-USB, JST, TRRS on one long edge, from Adafruit's CAD), Ø18
    knobs, and the Ender 3 V3 bed limit (pieces <= 210 x 210 mm).
    - v2 iteration prompt: four clashes found by re-running the v1 geometry
    with real data (module vs rear wall, no air under the HAT, faders don't
    fit, M4 connector edge) plus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
2026-10-19 docs(design): enclosure v2 from Claude Design + panel coordinate table
    - Save the v2 output and a REVIEW.md: v2 fixes the module, fader and M4
    clashes and splits the body into four 142 x 121 mm pieces for the
    Ender 3 V3. Remaining (body only, no control moves): the Pi can't be
    shifted off the module's centred mount pattern, which leaves 5.6 mm under
    the HAT (needs a 31-32 mm front or 16 deg); module-to-rear-wall is 1.1 mm.
    - hardware/panel/panel-coordinates.csv: every encoder, key, fader, pad,
    M4 and display mount hole with its board (PCB-A, PCB-F, PCB-K1,
    PCB-K2) -- the source for the PCB placement scripts.
2026-10-19 hw(boards): schematics for the four panel boards (PCB-A, PCB-F, PCB-K1, PCB-K2)
    One KiCad project per board under hardware/boards/, with a shared
    footprint library (Choc V2 from the Brain, ALPS RS6011P drawn from the
    RS6011SP6004 mounting-hole drawing: 6x Ø1.1 + 2x Ø2 locating, lugs as MP).
    - PCB-A: IDC 2x15 to the Brain carrier J5 (1:1 ribbon), 8 EC11 with
    10 nF on A/B, MCP23017 @0x20 for the encoder switches, I2C pull-ups,
    JST-SH to PCB-F and PCB-K1, JST-SH 4 (Qwiic) I2C in.
    - PCB-F: 4 RS6011 faders, 100 nF per wiper.
    - PCB-K1: 15 Choc V2 + SK6812MINI-EA, MCP23017 @0x21 and @0x22 (shared
    open-drain INT), LED chain out to PCB-K2 and back.
    - PCB-K2: 5 mode keys + LEDs.
    - CONNECTORS.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
2026-10-20 hw(boards): PCB-F and PCB-K2 placed and routed, DRC 0/0/0 with schematic parity
    Placement from panel-coordinates.csv (shared frame for all boards), Brain
    board tools reused (route_board/finish_routing/add_gnd_escapes/pours/fields),
    plus sync_from_netlist.py (MCP sync drops the '/' net prefix and BOM attrs)
    and build.sh to rebuild a board end to end. LED-window DRC rule copied
    from the Brain's PCB-K.
2026-10-22 hw(boards): all panel boards routed to DRC 0/0/0, add PCB-S shield adapter, fab outputs
    PCB-A, PCB-F, PCB-K1, PCB-K2 and the new PCB-S pass DRC with schematic parity and ERC.
    Single-sided bottom assembly; PCB-S ships bare (hand-soldered).
    - PCB-A: MCP23017 0x20 moved to SSOP-28 in the front band between E4 and E5; J4 (to PCB-K1)
    moved to the tab next to J1 (cable ~20-25 cm) so the bus stays off the encoder strip;
    strip front edge 99 -> 97.5; H4 onto the tab.
    - PCB-K1: MCP 0x21 pins reordered for a planar fan-out; U1 is SSOP-28; J2 over U2.
    - PCB-S: shield adapter for the carrier's J15/J16 (I2C -> JST-SH 4, Serial5 -> JST-PH 4 to the M4).
    - tools: grid router now sees footprint Edge.Cuts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
2026-10-22 docs(hw): MCP pin allocation, J4 cable and PCB-S in the connector contract
    - U1 0x20 and 0x21 key order set by the planar fan-out (firmware maps by name).
    - J4 cable to PCB-K1 is ~20-25 cm; PCB-S shield adapter pin table; pull-ups live on PCB-A.
    - T-B0-8 now points at PCB-S instead of a perfboard adapter.
